Q1anWan/GY-H1/Document/BOM_V1.1.xlsx

No. | Quantity | Comment | Designator | Footprint | Value | Manufacturer Part | Manufacturer | Supplier Part | Supplier
1 | 15 | 100nF | C1,C3,C6,C7,C10,C12,C13,C16,C17,C18,C19,C22,C24,C25,C26 | C0402 | 100nF | CL05B104KB54PNC | SAMSUNG(三星) | C307331 | LCSC
2 | 2 | 10uF | C2,C11 | C0603 | 10uF | CL10A106MA8NRNC | SAMSUNG(三星) | C96446 | LCSC
3 | 2 | 1uF | C4,C5 | C0603 | 1uF | 06033D105MAT2A | Kyocera AVX | C597124 | LCSC
4 | 2 | 4.7uF | C8,C9 | C0805 | 4.7uF | GRM21BC81H475KE11L | muRata(村田) | C237451 | LCSC
5 | 2 | 3.3uF | C14,C23 | C0603 | 3.3uF | GRM188B31A335KE15D | muRata(村田) | C528975 | LCSC
6 | 2 | 20pF | C15,C21 | C0402 | 20pF | GRM1555C1H200JA01D | muRata(村田) | C76959 | LCSC
7 | 1 | 10nF | C20 | C0402 | 10nF | GCM155R71H103KA55D | muRata(村田) | C91601 | LCSC
8 | 1 | XT30PW-M | CN1 | CONN-TH_XT30PW-M |  | XT30PW-M | AMASS(艾迈斯) | C431092 | LCSC
9 | 1 | A1257WR-S-4P | CN2 | CONN-SMD_A1257WR-S-4P |  | A1257WR-S-4P | CJT(长江连接器) | C225127 | LCSC
10 | 1 | ZMM9V1 | D1 | LL-34_L3.5-W1.5-RD |  | ZMM9V1 | Slkor(萨科微) | C707200 | LCSC
11 | 1 | DSK310 | D2 | SOD-123FL_L3.0-W1.8-LS3.7-R-RD |  | DSK310 | TWGMC(台湾迪嘉) | C727078 | LCSC
12 | 2 | PESD5V0S | D3,D4 | SOD-323_L1.8-W1.3-LS2.5-BI |  | PESD5V0S | Applied Power(应能微) | C712143 | LCSC
13 | 1 | PH-00316 | H1 | HDR-TH_4P-P2.54-V-M |  | PH-00316 | Liansheng(连盛) | C2829876 | LCSC
14 | 1 | ICM-42688-P | IMU1 | LGA-14_L3.0-W2.5-P0.50-TL |  | ICM-42688-P | TDK InvenSense(应美盛) | C1850418 | LCSC
15 | 1 | 4.7uH | L1 | IND-SMD_L4.5-W4.0-1 | 4.7uH | MCS0420-4R7MPN2 | PSA(信昌电陶) | C2937092 | LCSC
16 | 1 | XL-3528RGBW-WS2812B | LED1 | LED-SMD_4P-L3.5-W2.8-BR-1 |  | XL-3528RGBW-WS2812B | XINGLIGHT(成兴光) | C2890364 | LCSC
17 | 1 | WSD3066DN33 | Q1 | DFN-8_L3.3-W3.3-P0.65-BL |  | WSD3066DN33 | WINSOK(微硕) | C148386 | LCSC
18 | 1 | 270kΩ | R1 | R0402 | 270kΩ | RTT02274JTH | RALEC(旺诠) | C102943 | LCSC
19 | 1 | 51kΩ | R2 | R0402 | 51kΩ | ERJU2RD5102X | PANASONIC(松下) | C543820 | LCSC
20 | 1 | 47kΩ | R3 | R0402 | 47kΩ | 0402WGF4702TCE | UNI-ROYAL(厚声) | C25792 | LCSC
21 | 1 | 100kΩ | R4 | R0402 | 100kΩ | RMC 0402 100K F N | Tyohm(幸亚电阻) | C269673 | LCSC
22 | 4 | 22Ω | R5,R6,R17,R18 | R0402 | 22Ω | 0402WGJ0220TCE | UNI-ROYAL(厚声) | C25152 | LCSC
23 | 4 | 5.1kΩ | R7,R9,R10,R12 | R0402 | 5.1kΩ | ERJ2RKF5101X | PANASONIC(松下) | C278598 | LCSC
24 | 1 | 120Ω | R8 | R0402 | 120Ω | 0402WGF1200TCE | UNI-ROYAL(厚声) | C25079 | LCSC
25 | 3 | 10kΩ | R11,R19,R20 | R0402 | 10kΩ | 0402WGF1002TCE | UNI-ROYAL(厚声) | C25744 | LCSC
26 | 4 | 120Ω | R13,R14,R15,R16 | R0603 | 120Ω | 0603WAF1200T5E | UNI-ROYAL(厚声) | C22787 | LCSC
27 | 1 | MSK12C02 | SW1 | SW-TH_MSK12C02 |  | MSK12C02 | SHOU HAN(首韩) | C431540 | LCSC
28 | 2 | YTS-B001-1A | SW2,SW3 | SW-SMD_YIYUAN_YTS-B001-XX |  | YTS-B001-1A | YIYUAN(怡远) | C2910685 | LCSC
29 | 1 | RY8411 | U1 | SOT-23-6_L2.9-W1.6-P0.95-LS2.8-BL |  | RY8411 |  | C9900000347 | LCSC
30 | 1 | SK6019AD4-33 | U2 | XDFN-4_L1.0-W1.0-P0.65-BL-EP |  | SK6019AD4-33 | suntek(洺太电子) | C2682762 | LCSC
31 | 1 | MAX3051EKA+T | U3 | SOT-23-8_L3.0-W1.7-P0.65-LS2.8-TL |  | MAX3051EKA+T | MAXIM(美信) | C112005 | LCSC
32 | 1 | 20009-UCAF001-X | U4 | TYPE-C-SMD_20009-UCAF001-X |  | 20009-UCAF001-X | MINTRON(明硕) | C3148200 | LCSC
33 | 1 | GD32F303CET6 | U5 | LQFP-48_L7.0-W7.0-P0.50-LS9.0-BL |  | GD32F303CET6 | GigaDevice(兆易创新) | C2835084 | LCSC
34 | 1 | AO3400 | U6 | SOT-23-3_L2.9-W1.3-P1.90-LS2.4-BL-2 |  | AO3400 |  | C9900013365 | LCSC
35 | 4 |  | U7,U8,U9,U10 | M2.5孔
36 | 1 | GH125-S02DCA-00 | X1 | CONN-SMD_2P-P1.25_JUSHUO_GH125-S02DCA-00 |  | GH125-S02DCA-00 | JS(钜硕电子) | C2886765 | LCSC
37 | 1 | 8MHz | X2 | CRYSTAL-SMD_4P-L3.2-W2.5-BL-1 | 8MHz | CJ13-080001210C30 | CJ(江苏长电/长晶) | C2875275 | LCSC
