Q1anWan/GY-H1/Document/Calibration_Fixture.stl

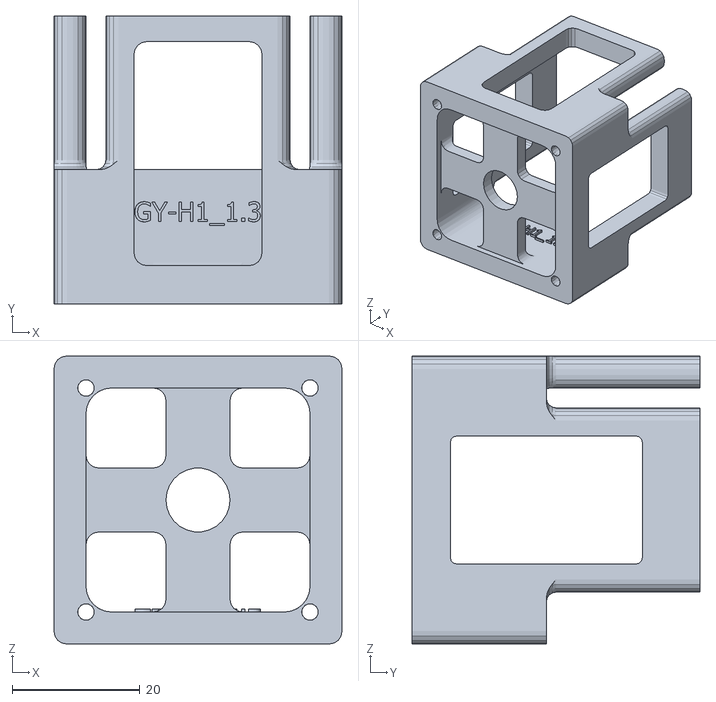
[picture p1: CAD file, 2023-03-31]
Document/Calibration_Fixture.stl
45.0 x 45.0 x 45.0
