Q1anWan/GY-H1/Document/Board_Shape.dxf

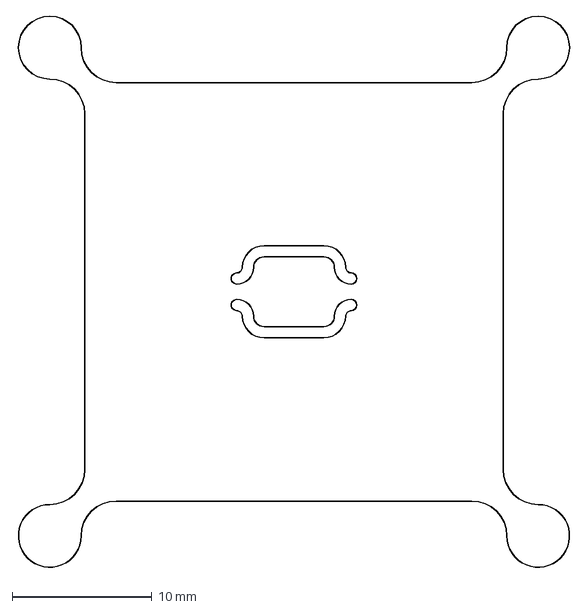
[picture p2: CAD file, 2023-03-31]
Document/Board_Shape.dxf
39.9 x 39.7 mm
