Q1anWan/GY-H1/(threads)

Thread 2 (2023-10-18):

[BUG提交] 使用上位机进行加速度计校准，写入数据时会出现OverflowError报错

Last-ID, 2023-10-18:
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

Q1anWan, 2023-10-18:
**这个问题是由于选用的ICM-42688芯片的Z轴加速度稳态误差超过了正常范围，这可能是由于不恰当的校准、或者体制较差的芯片引起。**
- ICM-42688芯片焊接后，建议在通电状态下保持24H以上进行老化，这将使得焊接导致的漂移回到正常水平，随后可以再次进行加速度计校准尝试。
- 如果使用AHRS系统，加速度计稳态误差并不重要

Thread 3 (2023-12-23):

IMU加热电阻咨询

qff233, 2023-12-23:
请问佬为何将nmos放在加热电阻的上端，nmos应该放到加热电阻的下端才会工作在饱和区吧，不然Vgs-Vth > Vds就进入了可变电阻区了呀。这个是故意设计，还是把他错当为pmos了？如果把nmos放到靠近地的位置的话，功率应该会提升到0.8W以上呀。

Q1anWan, 2023-12-23:
The layout of heating resistors is limited by the board shape of PCBA. Anyway, it doesn't need such high heating power to maintain the work temperature.

Closed 2023-12-23.
