Q1anWan/GY-H1/Document/SCH_V1.1.pdf

# VCC_5V C⁴ C⁰⁶⁰³ ¹uF

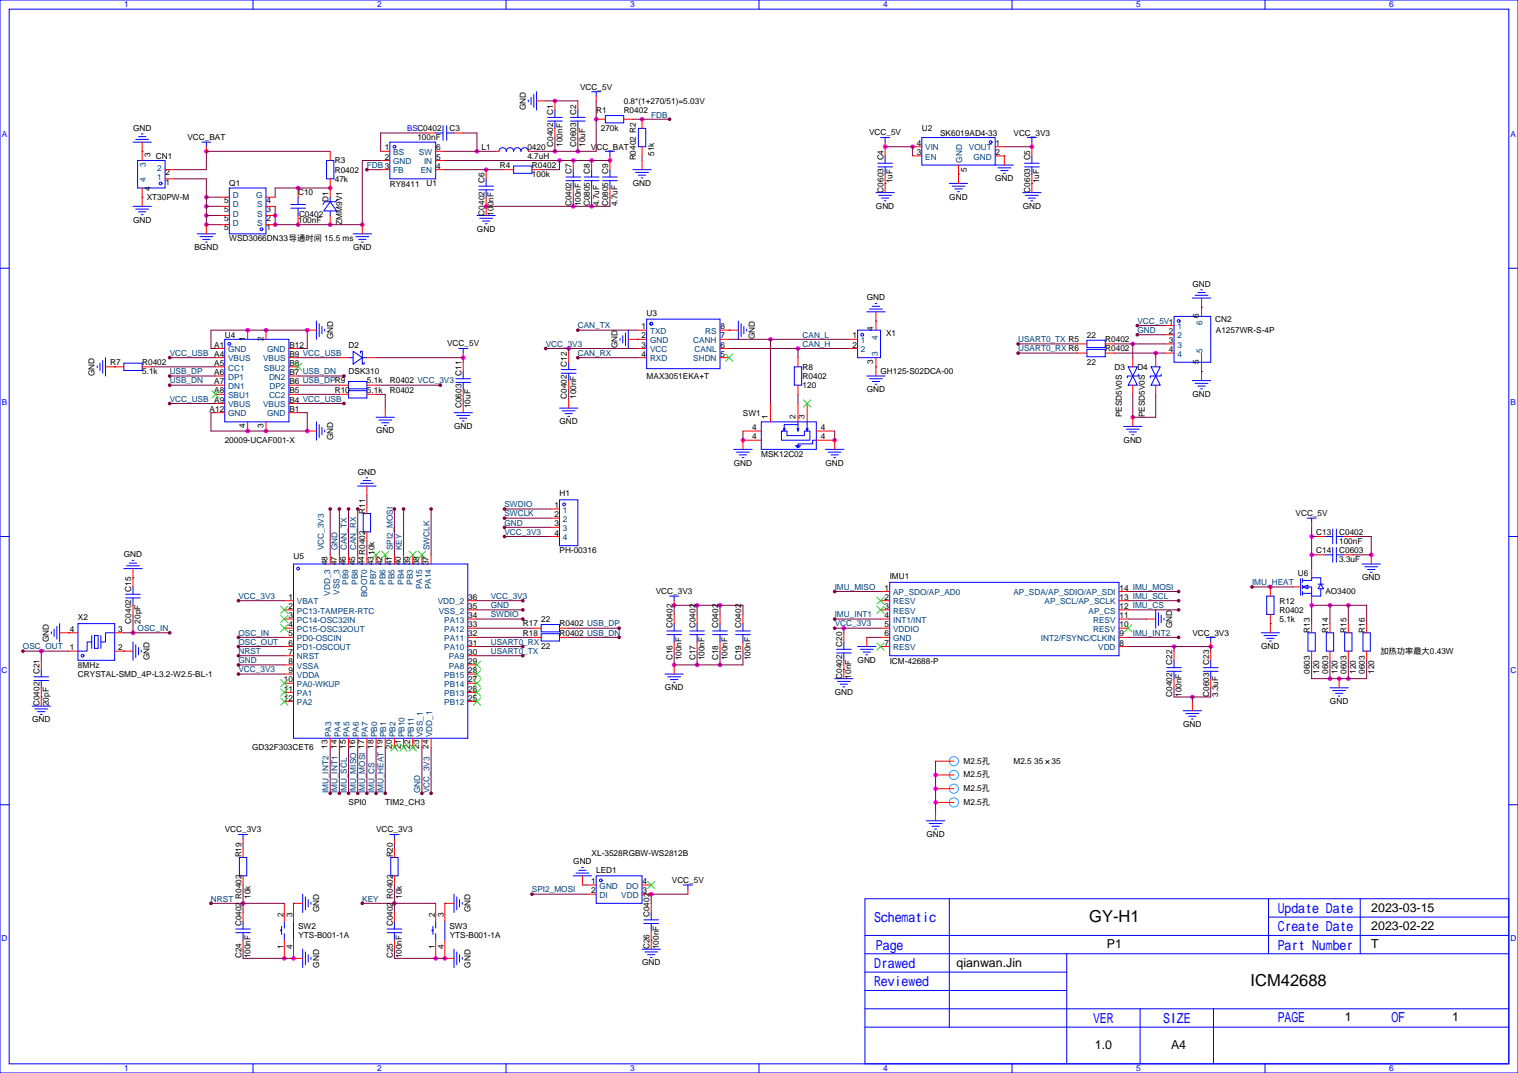
[picture p3: page 1]

GND B1 GND A12 VBUS A9 SBU1 A8 DN1 A7 DP1 A6 CC1 A5 VBUS A4 GND A1
