Q1anWan/GY-H1/Document/ASM_V1.1.pdf

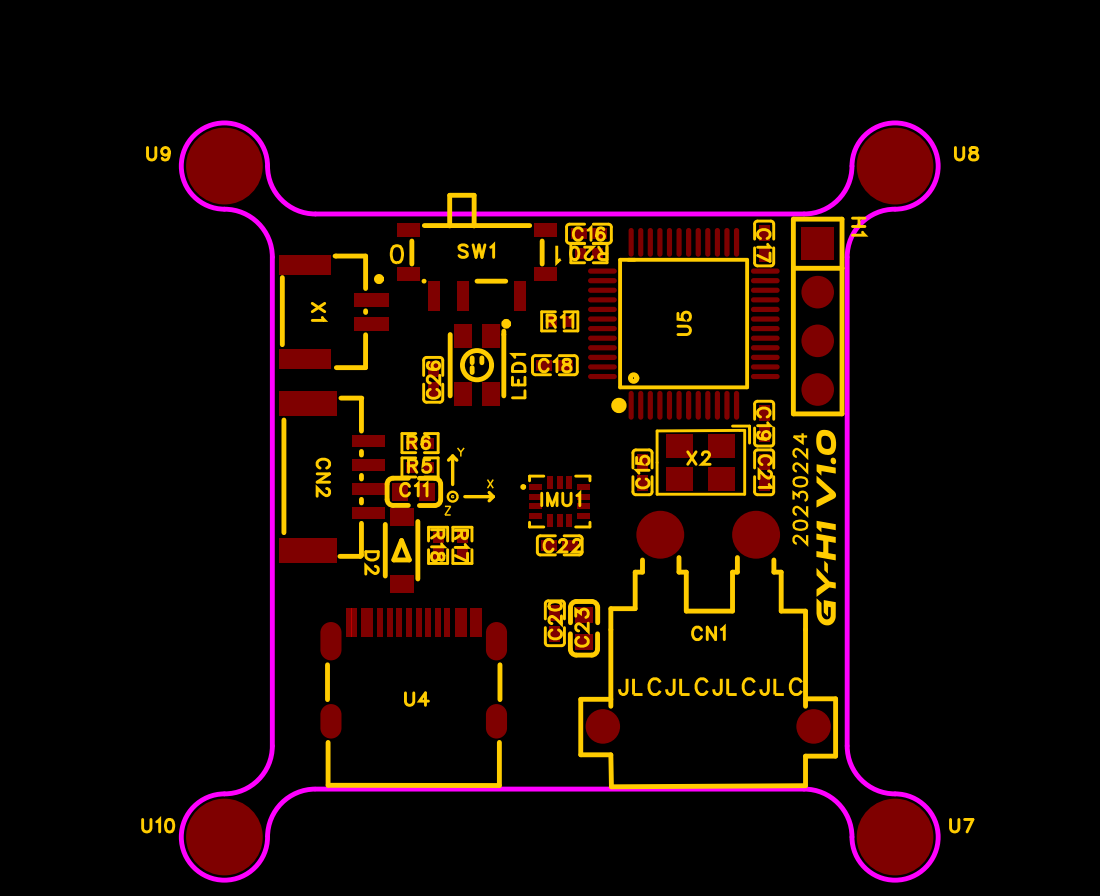
[picture p4: page 1]

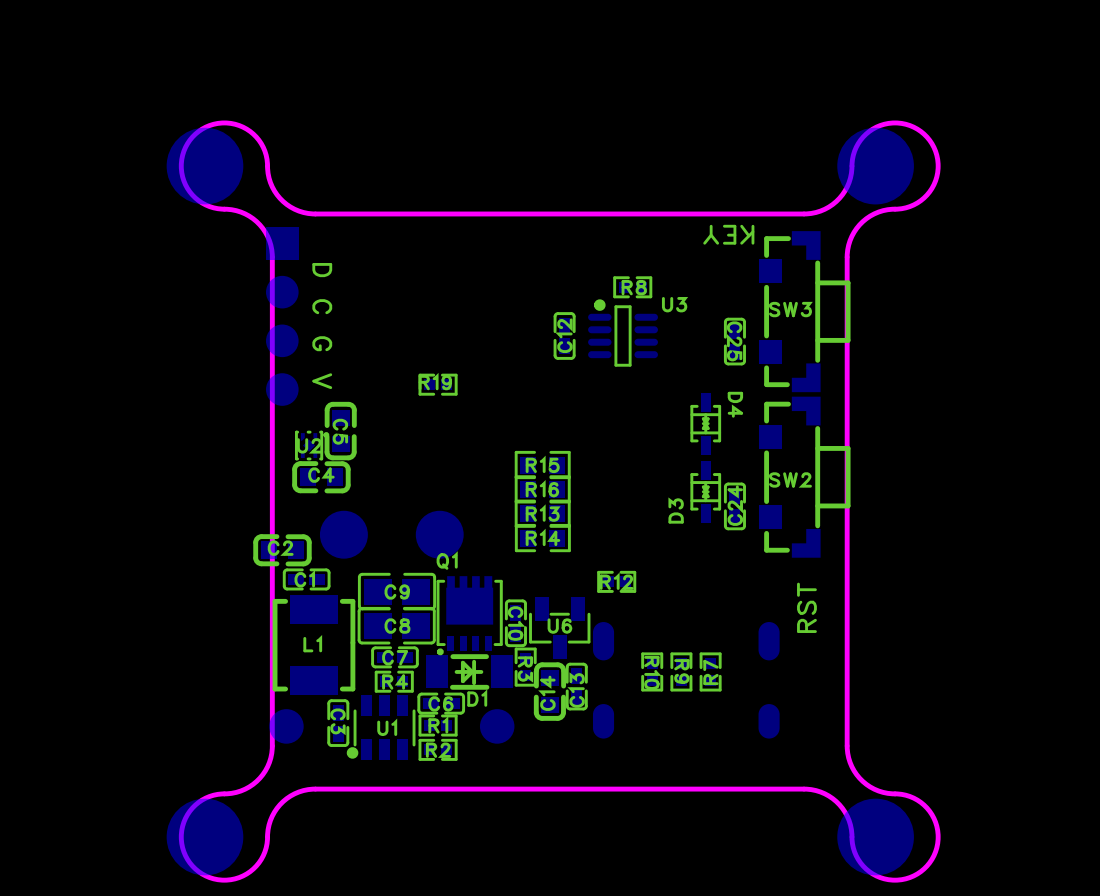
[picture p5: page 2]
