Q1anWan/GY-H1/Code/Drivers/PID.h

/*********************************************************************************
  *FileName:		PID.h
  *Author:  		qianwan
  *Detail: 			PID算法基类,PID_Init为纯虚函数
  
  *Version:  		1.2
  *Date:  			2023/03/13
  *Describe:		修补BUG
  
  *Version:  		1.1
  *Date:  			2023/02/26
  *Describe:		调整积分微分范围判定条件表达式

  *Version:  		1.0
  *Date:  			2023/02/10
  *Describe:		基于测试数据,取消对CMSIS-DSP的依赖
**********************************************************************************/
#ifndef PID_H
#define PID_H
#include "main.h"
#ifdef __cplusplus
class PID_Inc_C
{
	//增量式
	public:
	virtual void PID_Init() = 0;
	float PID_Cal(float fdb);
	float	Ref = 0.0f;
	float 	Error = 0.0f; //误差
	protected:
	float 	FeedBack = 0.0f;	
	float 	DError = 0.0f;
	float 	DDError = 0.0f;
	float 	PreError = 0.0f;
	float 	PreDError = 0.0f;
		
	float Kp=0.0f; //pid参数
	float Ki=0.0f;
	float Kd=0.0f;
	
	float IN_RANGE_EN_D = 0.0f;//开启微分项范围 值为0时始终开启
	float IN_RANGE_EN_I = 0.0f;//开启积分项范围 值为0时始终开启
	
	float MaxOutValue=0; //输出限幅
	float MinOutValue=0;
	
	public:
	float Out = 0.0f; //输出值
};

class PID_Pla_C
{
	//位置式
	public:
	virtual void PID_Init() = 0;
	float PID_Cal(float fdb);
	float	Ref = 0.0f;
	float 	Error = 0.0f; //误差
	protected:
	float 	FeedBack = 0.0f;	
	float 	DError = 0.0f;

	float integral = 0.0f;//误差的积分
	
	float Kp = 0.0f; //pid参数
	float Ki = 0.0f;
	float Kd = 0.0f;
	
	float IN_RANGE_EN_D = 0.0f;//开启微分项范围 值为0时始终开启
	float IN_RANGE_EN_I = 0.0f;//开启积分项范围 值为0时始终开启
	
	float MaxOutValue = 0; //输出限幅
	float MinOutValue = 0;

	float Maxintegral = 0.0f; //积分限幅
	float Minintegral = 0.0f;
	
	public:
	float Out = 0.0f; //输出值
};

#endif
#endif
