Q1anWan/GY-H1/Code/Algorithm/IMU.cpp

#include "IMU.h"
#include "MsgThread.h"
#include "Controller.h"
#include "QuaternionEKF.h"
#include "Flash_GD.h"

cIMU tIMU;
cIMU *IMU = &tIMU;
/*IMU进程控制指针*/
rt_thread_t IMU_thread = RT_NULL;
rt_thread_t IMUSlaver_thread = RT_NULL;
rt_thread_t IMUAHRS_thread = RT_NULL;
rt_thread_t IMUHeat_thread = RT_NULL;
rt_sem_t IMU_INT1Sem = RT_NULL;	
rt_sem_t IMU_INT2Sem = RT_NULL;

static void IMU_PreInit(void);
static void IMU_Init(void);
static void IMUCalibRead(void);

extern void IMU_QuaternionEKF_Init(float process_noise1, float process_noise2, float measure_noise, float lambda, float dt);
extern void IMU_QuaternionEKF_Update(float *q, float gx, float gy, float gz, float ax, float ay, float az);
extern void IMU_QuaternionEKF_Reset(void);

void IMUThread(void* parameter)
{
	rt_tick_t ticke=0;
	
	IMUCalibRead();
	IMU->SPI_Init(SPI0,GPIOB,GPIO_PIN_0);
	IMU_PreInit();
	
	ticke = rt_tick_get();
	/*最多等5s*/	
	while( (IMU->Temperature<40.5f)&&((rt_tick_get()-ticke)>5000) )
	{
		//50Hz温度读取
		IMU->ReadTem();
		rt_thread_delay(20);
	}
	IMU_Init();//预热完成后再正初始化
	qCtr->TemperatureOK=1;
	
	for(;;)
	{
		rt_sem_take(IMU_INT1Sem,RT_WAITING_FOREVER);
		/*读取中断位*/
		if(IMU->ReadReg(0x2D)&0x08)
		{
			IMU->ReadAccelGyro();
			rt_enter_critical();
			IMU->AccelCorrected[0] = ((float)IMU->Accel[0] + IMU->AccelCal[0]) * IMU->LSB_ACC_GYRO[0];
			IMU->AccelCorrected[1] = ((float)IMU->Accel[1] + IMU->AccelCal[1]) * IMU->LSB_ACC_GYRO[0];
			IMU->AccelCorrected[2] = ((float)IMU->Accel[2] + IMU->AccelCal[2]) * IMU->LSB_ACC_GYRO[0];
			IMU->GyroCorrected[0] = ((float)IMU->Gyro[0] + IMU->GyroCal[0]) * IMU->LSB_ACC_GYRO[1];
			IMU->GyroCorrected[1] = ((float)IMU->Gyro[1] + IMU->GyroCal[1]) * IMU->LSB_ACC_GYRO[1];
			IMU->GyroCorrected[2] = ((float)IMU->Gyro[2] + IMU->GyroCal[2]) * IMU->LSB_ACC_GYRO[1];			
			rt_exit_critical();
			IMU->ReadTem();
		}
	}
}

void IMU2Thread(void* parameter)
{
	for(;;)
	{
		rt_sem_take(IMU_INT2Sem,RT_WAITING_FOREVER);
	}
}

void IMUAHRSThread(void* parameter)
{
	rt_thread_delay(1000);
	rt_tick_t ticker;
	/*Ready to start EKF*/
	rt_enter_critical();
	IMU_QuaternionEKF_Init(10, 0.001, 10000000, 1, 0.001f);
	rt_exit_critical();
	/*等待温度补偿OK*/
	while(!qCtr->TemperatureOK){rt_thread_delay(100);}

	for(;;)
	{
		ticker = rt_tick_get();
		rt_enter_critical();
		/*EKF迭代四元数*/
		IMU_QuaternionEKF_Update(IMU->Q,IMU->GyroCorrected[0],IMU->GyroCorrected[1],IMU->GyroCorrected[2],IMU->AccelCorrected[0],IMU->AccelCorrected[1],IMU->AccelCorrected[2]);
		rt_exit_critical();
		rt_thread_delay_until(&ticker,1);
	}
}	
	
void IMUHeatThread(void* parameter)
{
	rt_tick_t Ticker = 0;
	uint32_t PWM=0;
	/*等待IMU预初始化*/
	rt_thread_delay(20);
	
	for(;;)
	{
		Ticker = rt_tick_get();		
		PWM = (uint32_t)IMU->PID_Cal(IMU->Temperature);
		timer_channel_output_pulse_value_config(TIMER2,TIMER_CH_3,PWM);
		rt_thread_delay_until(&Ticker,20);
	}
}

void EXTI3_IRQHandler(void)
{
	if(exti_flag_get(EXTI_3))
	{
		exti_flag_clear(EXTI_3);
		rt_sem_release(IMU_INT2Sem);
	}
	
}

void EXTI4_IRQHandler(void)
{
	if(exti_flag_get(EXTI_4))
	{
		exti_flag_clear(EXTI_4);
		rt_sem_release(IMU_INT1Sem);
	}
}
//IMU预初始化 用于完成加热动作
static void IMU_PreInit()
{
	uint8_t buf = 0;
	/*指定Bank0*/
	IMU->WriteReg(0x76,0x00);
	/*软重启*/
	IMU->WriteReg(0x11,0x01);rt_thread_delay(5);
	/*读取中断位 切换SPI*/
	buf = IMU->ReadReg(0x2D);
	/*指定Bank0*/
	IMU->WriteReg(0x76,0x00);
	/*Gyro设置*/
	IMU->WriteReg(0x4F,0x06);//2000dps 1KHz
	/*Accel设置*/
	IMU->WriteReg(0x50,0x06);//16G 1KHz
	/*电源管理*/
	IMU->WriteReg(0x4E,0x0F);//ACC GYRO LowNoise Mode
}

//IMU初始化 用于正常工作
static void IMU_Init()
{
	uint8_t buf = 0;
	/*指定Bank0*/
	IMU->WriteReg(0x76,0x00);
	/*软重启*/
	IMU->WriteReg(0x11,0x01);rt_thread_delay(5);
	/*读取中断位 切换SPI*/
	buf = IMU->ReadReg(0x2D);
	#ifdef qwDbug
	/*打印IMU信息*/
	rt_kprintf("\n/*****\nRST MSG: %d\nIMU Conect = %d\n*****/\n",buf,IMU->ReadReg(0x75));
	#endif
	
	/*指定Bank0*/
	IMU->WriteReg(0x76,0x00);
	/*中断输出设置*/
	IMU->WriteReg(0x14,0x12);//INT1 INT2 脉冲模式，低有效
	/*Gyro设置*/
	IMU->WriteReg(0x4F,0x06);//2000dps 1KHz
	/*Accel设置*/
	IMU->WriteReg(0x50,0x06);//16G 1KHz
	/*LSB设置*/
	IMU->cICM42688::LSB_ACC_GYRO[0] = LSB_ACC_16G;
	IMU->cICM42688::LSB_ACC_GYRO[1] = LSB_GYRO_2000_R;
	/*Tem设置&Gyro_Config1*/
	IMU->WriteReg(0x51,0x56);//BW 82Hz Latency = 2ms
	/*GYRO_ACCEL_CONFIG0*/
	IMU->WriteReg(0x52,0x11);//1BW
	/*ACCEL_CONFIG1*/
	IMU->WriteReg(0x53,0x0D);//Null
	/*INT_CONFIG0*/
	IMU->WriteReg(0x63,0x00);//Null
	/*INT_CONFIG1*/
	IMU->WriteReg(0x64,0x00);//中断引脚正常启用
	/*INT_SOURCE0*/
	IMU->WriteReg(0x65,0x08);//DRDY INT1
	/*INT_SOURCE1*/
	IMU->WriteReg(0x66,0x00);//Null
	/*INT_SOURCE3*/
	IMU->WriteReg(0x68,0x00);//Null
	/*INT_SOURCE3*/
	IMU->WriteReg(0x69,0x00);//Null
	
/*****抗混叠滤波器@536Hz*****/
	
	/*GYRO抗混叠滤波器配置*/
	/*指定Bank1*/
	IMU->WriteReg(0x76,0x01);
	/*GYRO抗混叠滤波器配置*/
	IMU->WriteReg(0x0B,0xA0);//开启抗混叠和陷波滤波器
	IMU->WriteReg(0x0C,0x0C);//GYRO_AAF_DELT 12 (default 13)
	IMU->WriteReg(0x0D,0x90);//GYRO_AAF_DELTSQR 144 (default 170)
	IMU->WriteReg(0x0E,0x80);//GYRO_AAF_BITSHIFT 8 (default 8)
	
	/*ACCEL抗混叠滤波器配置*/
	/*指定Bank2*/
	IMU->WriteReg(0x76,0x02);
	/*ACCEL抗混叠滤波器配置*/
	IMU->WriteReg(0x03,0x18);//开启滤波器 ACCEL_AFF_DELT 12 (default 24)
	IMU->WriteReg(0x04,0x90);//ACCEL_AFF_DELTSQR 144 (default 64)
	IMU->WriteReg(0x05,0x80);//ACCEL_AAF_BITSHIFT 8 (default 6)

/*****自定义滤波器1号@111Hz*****/

	/*指定Bank0*/
	IMU->WriteReg(0x76,0x00);
	/*滤波器顺序*/
	IMU->WriteReg(0x51,0x12);//GYRO滤波器1st
	IMU->WriteReg(0x53,0x05);//ACCEL滤波器1st
	/*滤波器设置*/
	IMU->WriteReg(0x52,0x33);//111Hz 03

	
	exti_flag_clear(EXTI_3);
	exti_flag_clear(EXTI_4);
	exti_interrupt_enable(EXTI_3);
	exti_interrupt_enable(EXTI_4);
	
	/*指定Bank0*/
	IMU->WriteReg(0x76,0x00);
	/*电源管理*/
	IMU->WriteReg(0x4E,0x0F);//ACC GYRO LowNoise Mode
}

static void IMUCalibRead(void)
{	
	uint32_t buf[4];
	
	fmc_read_u32(FLASH_USERDATA_ADDRESS+4,buf,3);
	
	IMU->GyroCal[0] = ((float)((int16_t)(buf[0]>>16)))/1000.0f;
	IMU->GyroCal[1] = ((float)((int16_t)(buf[0]&0xFFFF)))/1000.0f;
	IMU->GyroCal[2] = ((float)((int16_t)(buf[1]>>16)))/1000.0f;
	IMU->AccelCal[0] = ((float)((int16_t)(buf[1]&0xFFFF)))/1000.0f;
	IMU->AccelCal[1] = ((float)((int16_t)(buf[2]>>16)))/1000.0f;
	IMU->AccelCal[2] = ((float)((int16_t)(buf[2]&0xFFFF)))/800.0f;
}
