Q1anWan/GY-H1/(commit log)

2023-03-09 串口基本完成
2023-03-10 针对RT-Thread的串口任务研发就此为止，后续改为阻塞型
2023-03-11 此版本单独使用缓冲模式或者单独使用直接发送模式都正常，但不能一起用
2023-03-11 作为42688开发的基础版本
2023-03-15 大幅更新ReadME
2023-03-15 CAN/USB切换功能实现，配置功能实现
2023-03-17 串口配置功能OK
2023-03-17 README更新
2023-03-17 完成用户接口输出设置
2023-03-18 Update Documents
    [BOM_V1.1.xlsx]
2023-03-18 优化LED灯显示效果
    [BOM_V1.1.xlsx]
2023-03-18 增加对板载LED的描述
2023-03-18 KEY设置机制写了一半
    [PlaceV1.1.csv]
2023-03-19 完善按钮设置代码及文档
2023-03-20 上位机配置部分搞定了
2023-03-21 修正GD32程序中的几个小问题,上位机程序增加串口接收IMU数据
2023-03-22 上位机校准动态UI搞定,角速度校准搞定
2023-03-23 修正了上位机程序的几个小BUG，重新用类封装变量
2023-03-24 修复了上位机写入错误的问题
2023-03-24 修改上位机程序芯片连接设置,IMU温控增加RC滤波
2023-03-25 优化上位机校准程序
2023-03-27 四元数引入，优化标定
2023-03-28 AHRS引入及优化
2023-03-29 出现内存溢出错误
2023-03-29 内存溢出解决
2023-03-29 修复溢出
2023-03-29 修复溢出问题
2023-03-29 修复内存溢出问题
2023-03-29 更新串口波特率,上位机适配校准格式
    [GyroCalibrationData_21H15M15S.csv, GyroCalibrationData_21H24M24S.csv, GyroCalibrationData_22H48M48S.csv]
2023-03-30 “修改IMU信号链设置”
    [GyroCalibrationData_21H15M15S.csv, GyroCalibrationData_21H24M24S.csv, GyroCalibrationData_22H48M48S.csv]
2023-03-31 调试四元数稳定性
2023-03-31 上位机Accel校准程序修改
2023-03-31 V1.0版本发布
    [Board_Shape.dxf, Calibration_Fixture.stl]
2023-03-31 修正对串口波特率的描述
2023-04-06 使能按钮切换功能,修改对单片机型号的描述
    [BOM_V1.1.xlsx, PlaceV1.1.csv]
2023-04-07 上位机1.1版本，修复加速度计校准问题
2023-04-09 添加渲染图
2023-05-06 修复CAN总线问题
2023-05-20 V1.2.1版本, 改进了四元数支持函数中一个未被使用的功能
